FrancescoRocca/hackTurin-2026/openscad/smart-camera/previews/body_back.png

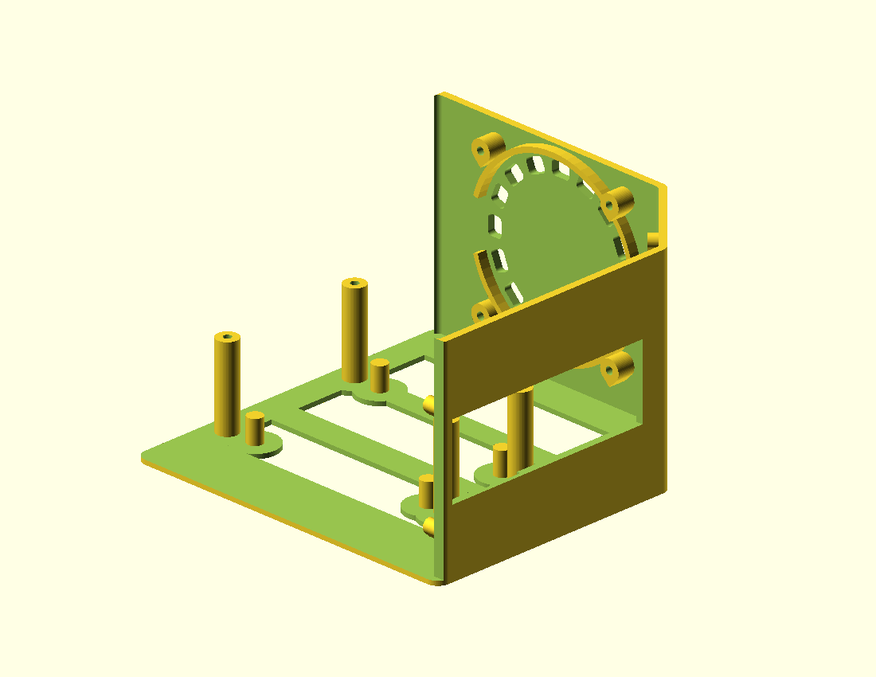
openscad/smart-camera/previews/body_back.png
