FrancescoRocca/hackTurin-2026/openscad/smart-camera/previews/body_front.png

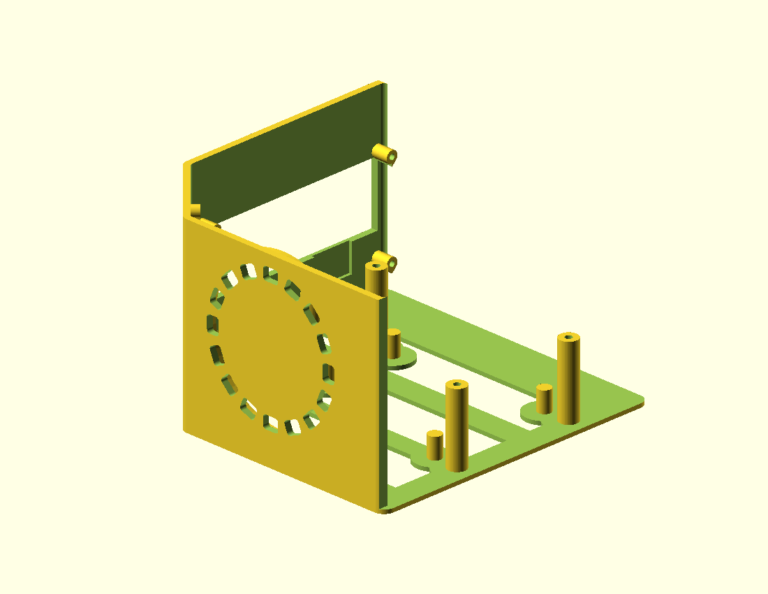
openscad/smart-camera/previews/body_front.png
