FrancescoRocca/hackTurin-2026/openscad/smart-camera/previews/body_top_inside.png

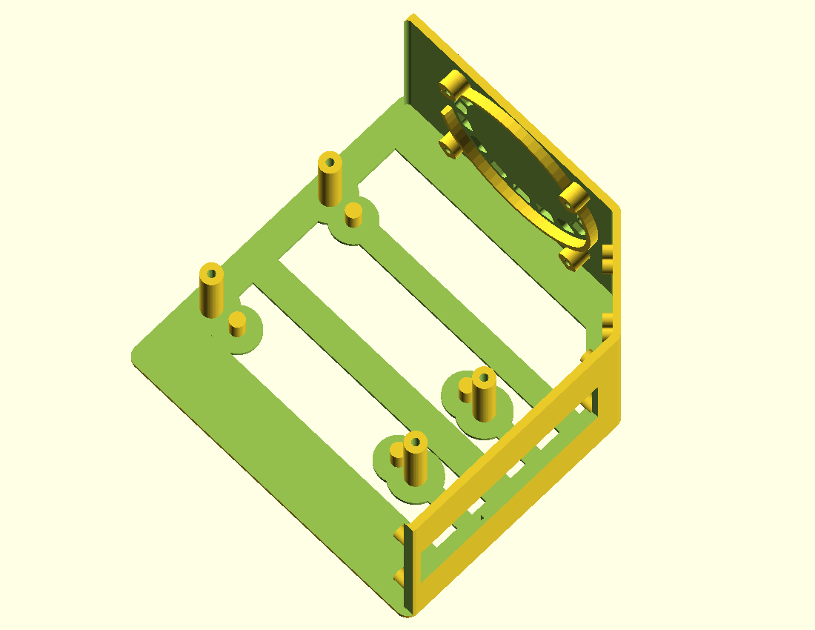
openscad/smart-camera/previews/body_top_inside.png
