FrancescoRocca/hackTurin-2026/openscad/smart-camera/previews/buzzer.png

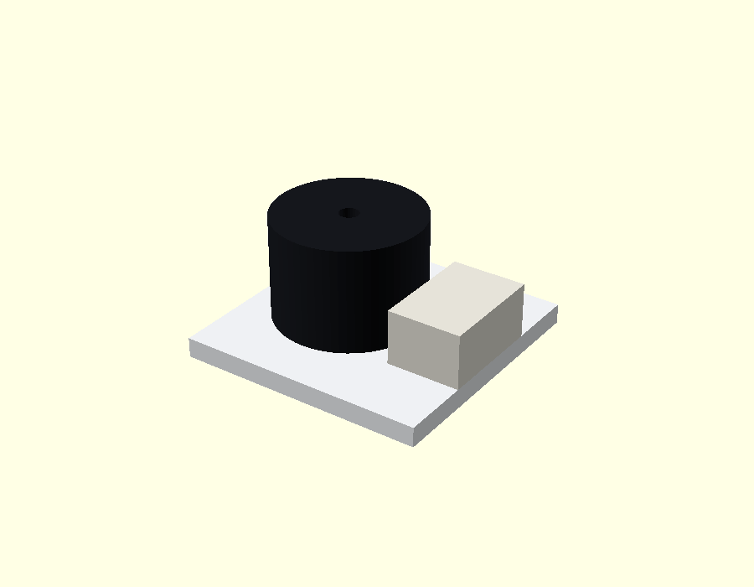
openscad/smart-camera/previews/buzzer.png
