FrancescoRocca/hackTurin-2026/openscad/smart-camera/previews/buzzer_fit_close.png

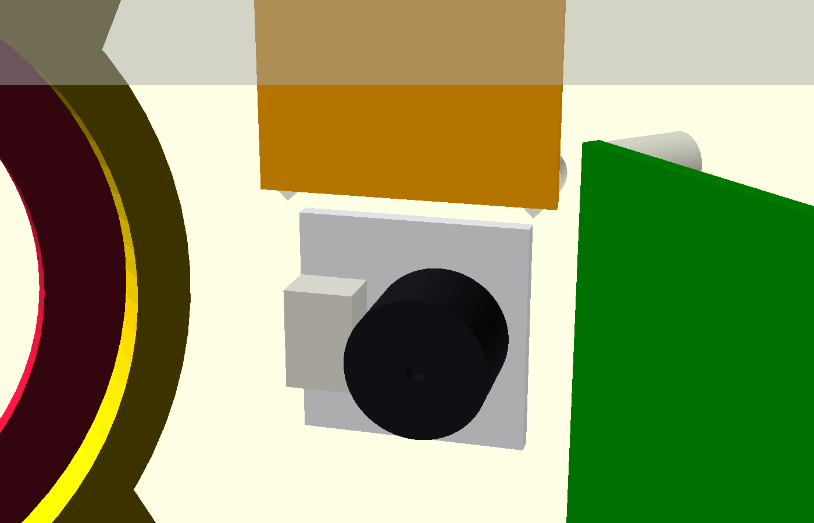
openscad/smart-camera/previews/buzzer_fit_close.png
