FrancescoRocca/hackTurin-2026/openscad/smart-camera/previews/camera_front.png

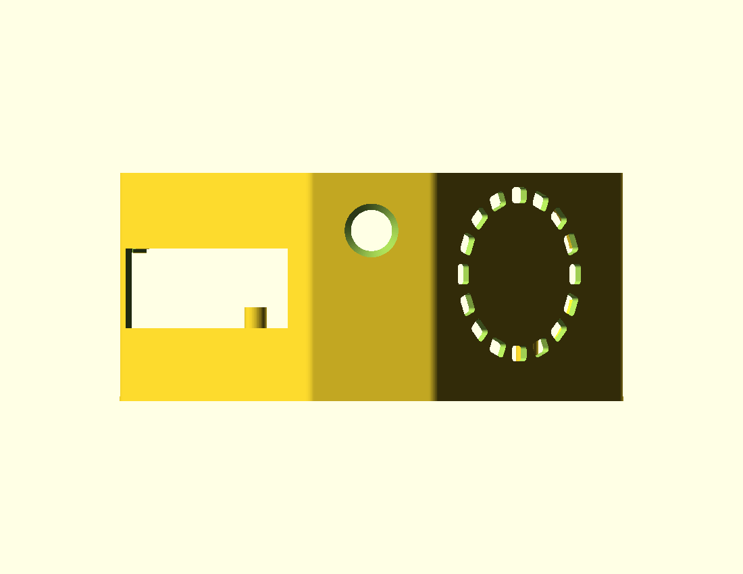
openscad/smart-camera/previews/camera_front.png
