FrancescoRocca/hackTurin-2026/openscad/smart-camera/previews/clamp_inner.png

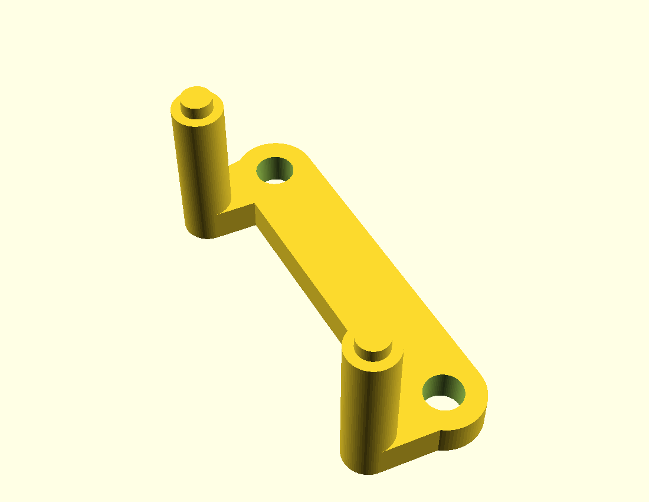
openscad/smart-camera/previews/clamp_inner.png
