FrancescoRocca/hackTurin-2026/openscad/smart-camera/previews/clamp_usb.png

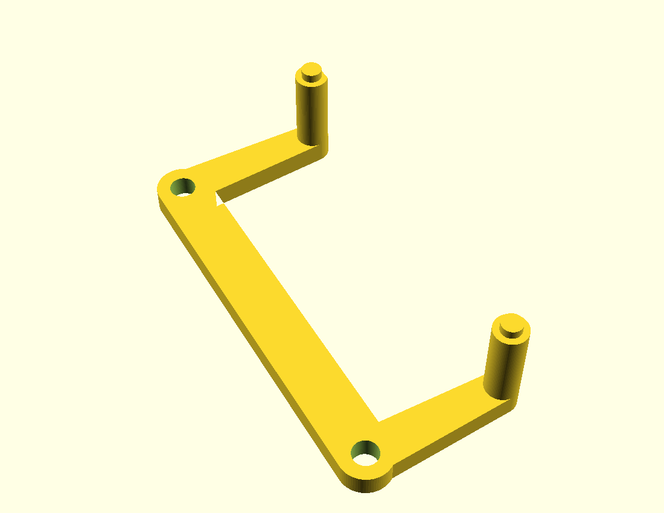
openscad/smart-camera/previews/clamp_usb.png
