FrancescoRocca/hackTurin-2026/openscad/smart-camera/previews/fit_back_buzzer.png

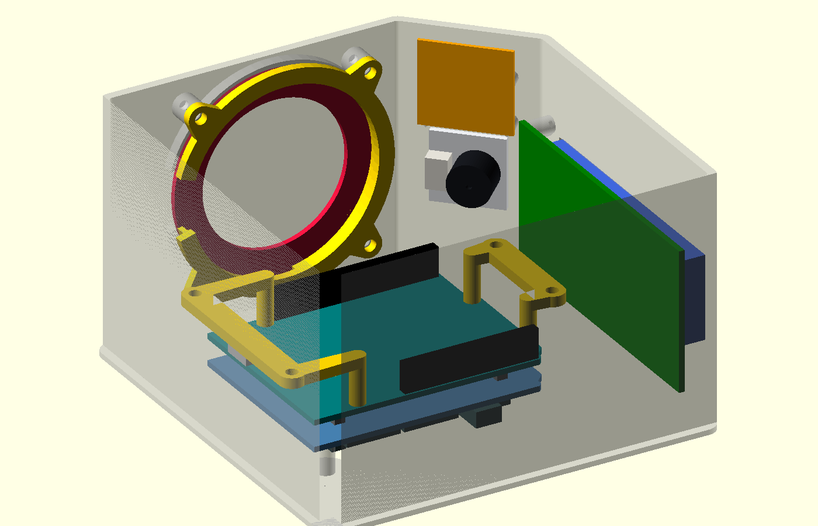
openscad/smart-camera/previews/fit_back_buzzer.png
