FrancescoRocca/hackTurin-2026/openscad/smart-camera/previews/fit_front.png

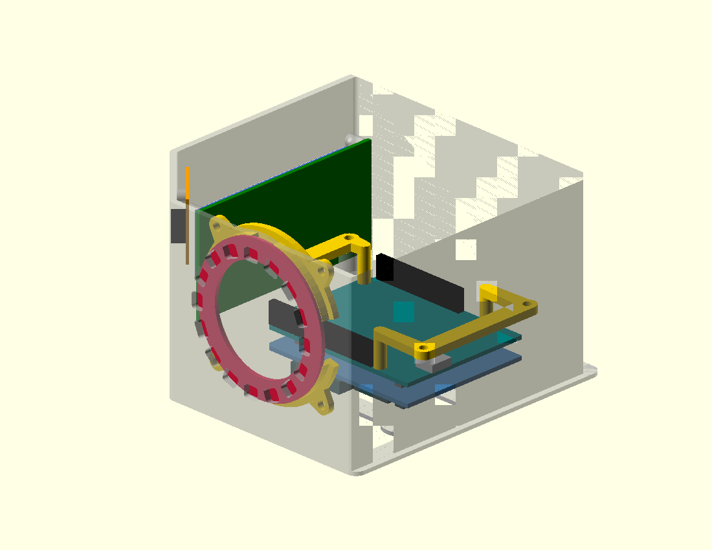
openscad/smart-camera/previews/fit_front.png
