FrancescoRocca/hackTurin-2026/openscad/smart-camera/previews/fit_left_inside.png

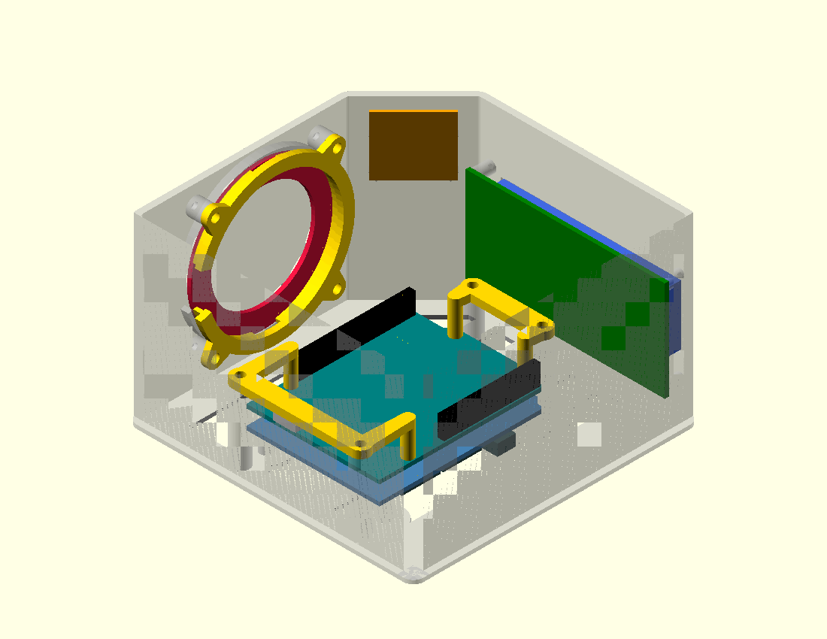
openscad/smart-camera/previews/fit_left_inside.png
