FrancescoRocca/hackTurin-2026/openscad/smart-camera/previews/lid.png

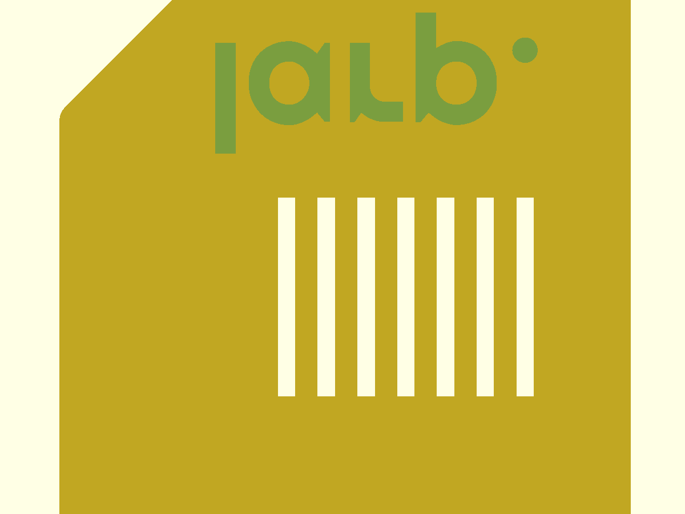
openscad/smart-camera/previews/lid.png
