FrancescoRocca/hackTurin-2026/openscad/smart-camera/previews/ring_retainer.png

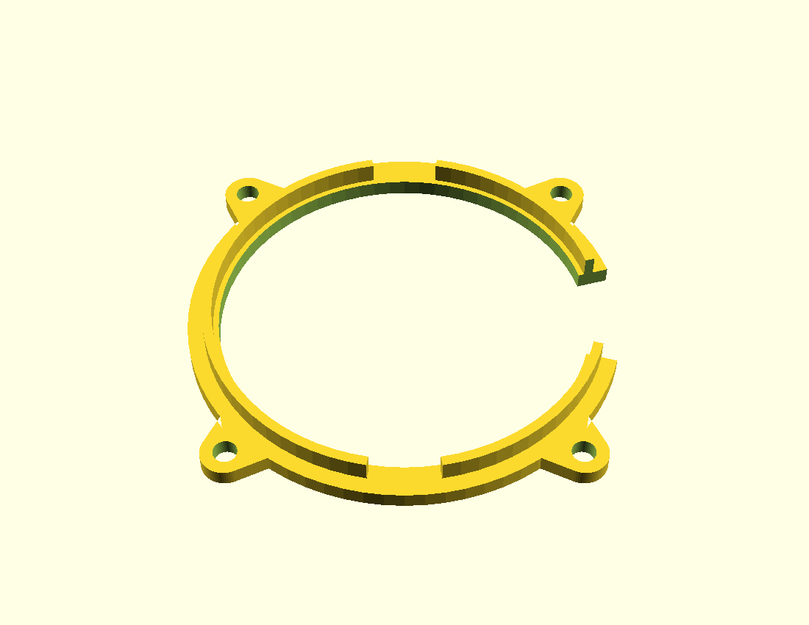
openscad/smart-camera/previews/ring_retainer.png
