FrancescoRocca/hackTurin-2026/openscad/smart-camera/renders/body_before.png

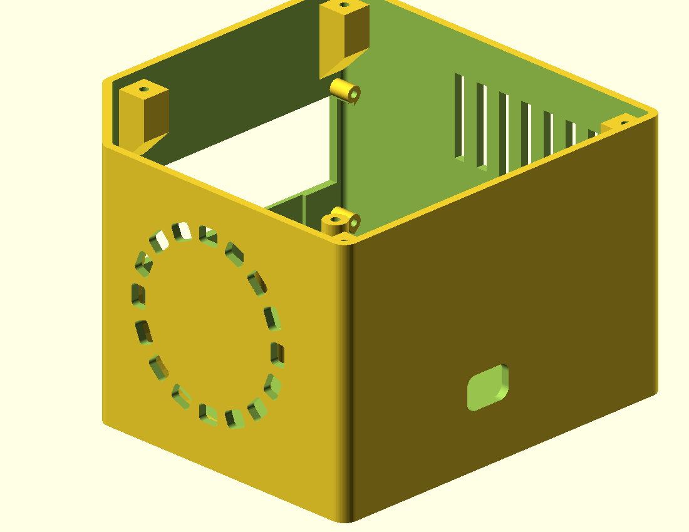
openscad/smart-camera/renders/body_before.png
