FrancescoRocca/hackTurin-2026/openscad/smart-camera/video/stl/body_asm.stl

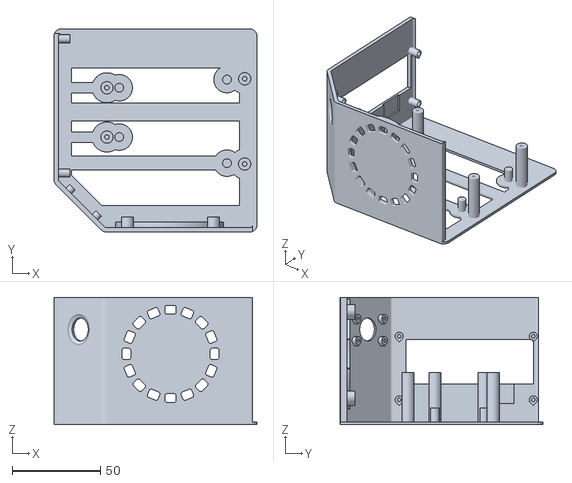
[picture p19: CAD file, 2026-10-11]
openscad/smart-camera/video/stl/body_asm.stl
115.0 x 115.0 x 72.0
