FrancescoRocca/hackTurin-2026/openscad/smart-camera/video/stl/clamp_usb_asm.stl

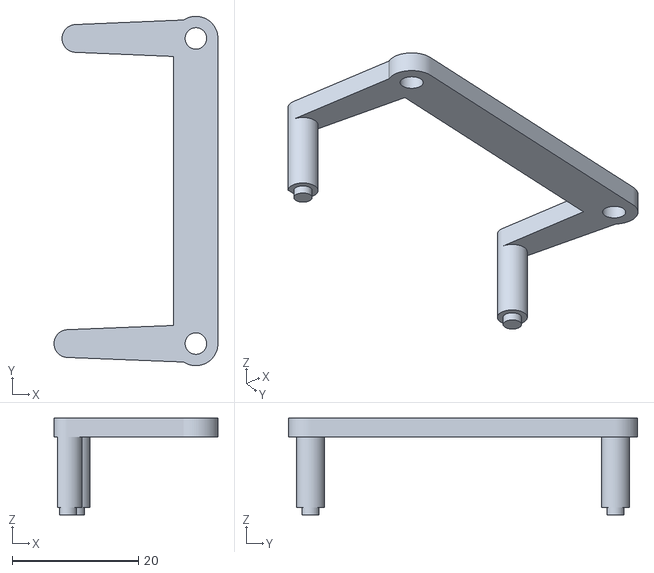
[picture p20: CAD file, 2026-10-11]
openscad/smart-camera/video/stl/clamp_usb_asm.stl
25.9 x 55.3 x 15.3
