FrancescoRocca/hackTurin-2026/openscad/smart-camera/video/stl/lid_asm.stl

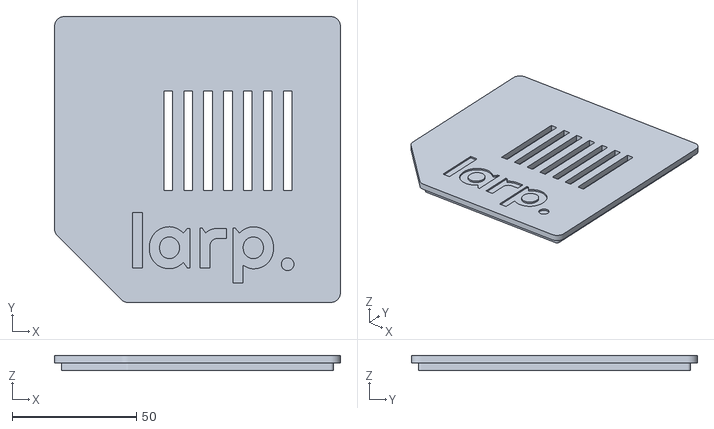
[picture p21: CAD file, 2026-10-11]
openscad/smart-camera/video/stl/lid_asm.stl
115.0 x 115.0 x 6.00
