FrancescoRocca/hackTurin-2026/openscad/smart-camera/video/stl/clamp_inner_asm.stl

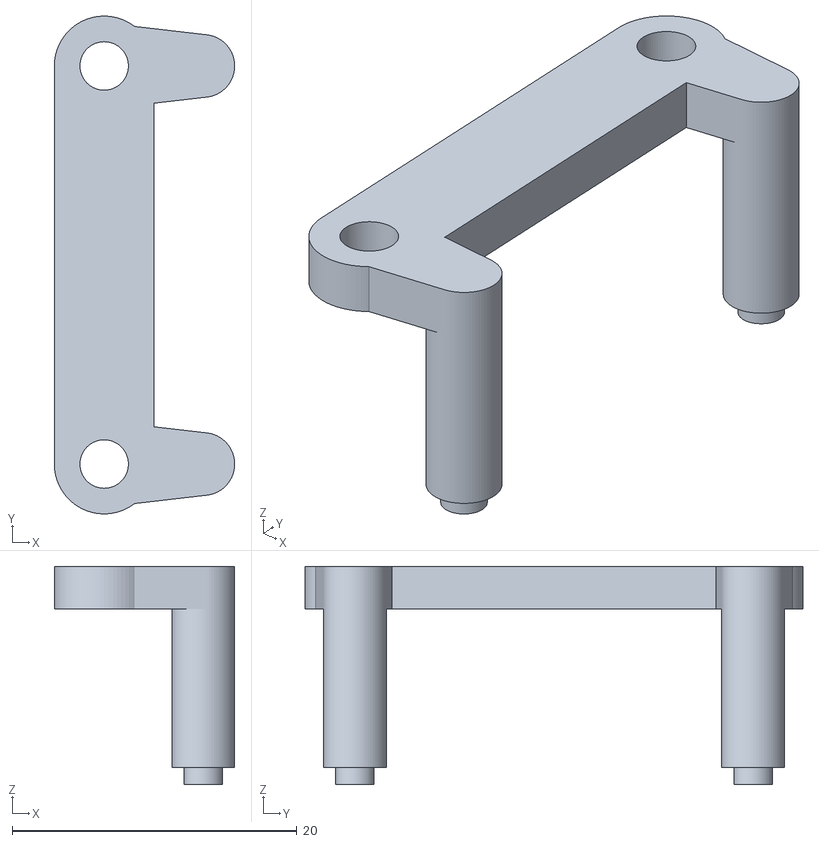
[picture p22: CAD file, 2026-10-11]
openscad/smart-camera/video/stl/clamp_inner_asm.stl
12.7 x 34.9 x 15.3
