FrancescoRocca/hackTurin-2026/openscad/smart-camera/video/stl/retainer_asm.stl

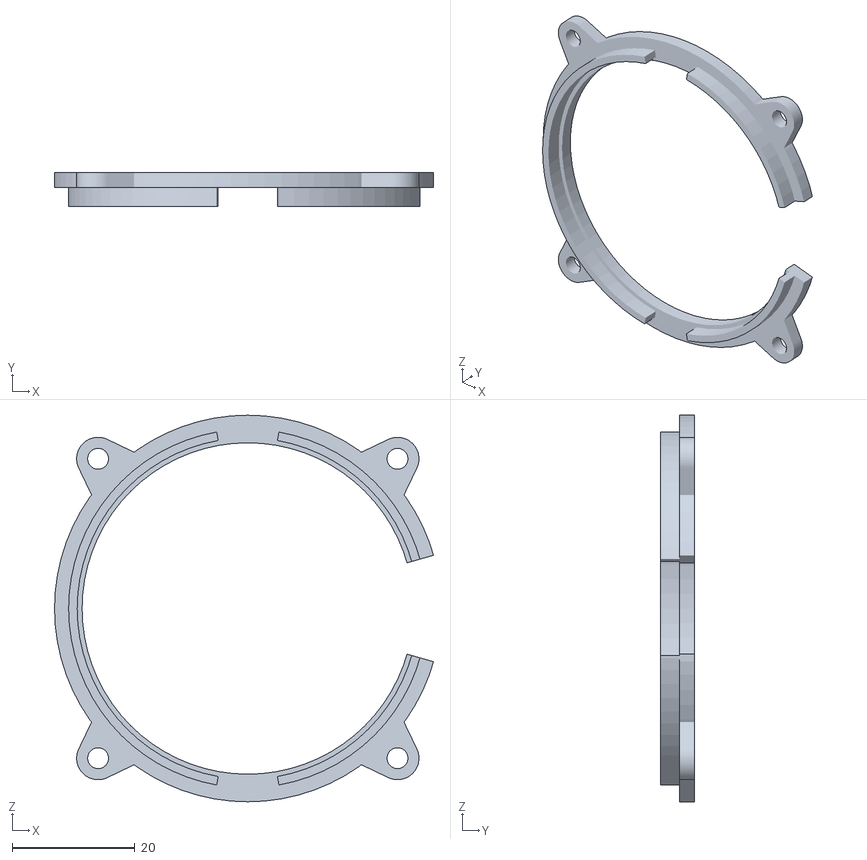
[picture p23: CAD file, 2026-10-11]
openscad/smart-camera/video/stl/retainer_asm.stl
61.8 x 5.60 x 63.0
