FrancescoRocca/hackTurin-2026/openscad/smart-camera/stl/grove_passive_buzzer_mock.stl

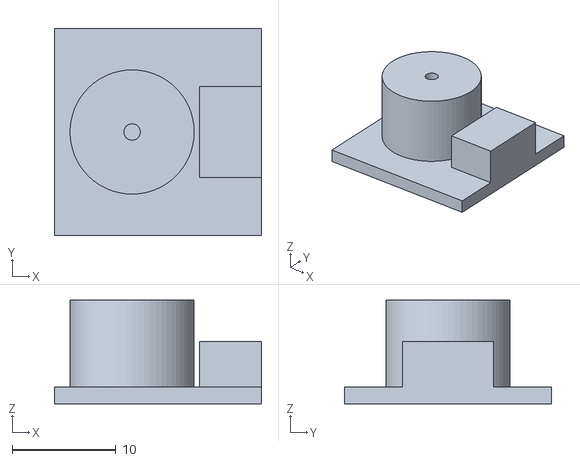
[picture p24: CAD file, 2026-10-11]
openscad/smart-camera/stl/grove_passive_buzzer_mock.stl
20.0 x 20.0 x 10.0
