FrancescoRocca/hackTurin-2026/openscad/smart-camera/stl/smart_camera_logo_inlay.stl

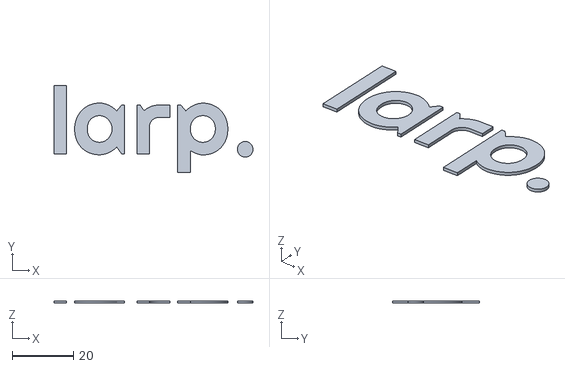
[picture p25: CAD file, 2026-10-11]
openscad/smart-camera/stl/smart_camera_logo_inlay.stl
64.9 x 28.4 x 0.8
