FrancescoRocca/hackTurin-2026/openscad/smart-camera/logo/larp_logo.scad

// 2D "larp" wordmark, identical to the text engraved on the lid
// (same font, size, spacing as smart_camera_enclosure.scad).
// Export:  openscad -o logo/larp.svg logo/larp_logo.scad     (from smart-camera/)
include <../smart_camera_enclosure.scad>
part = "none";
logo_text2d();
