FrancescoRocca/hackTurin-2026/(list of files, cad)

Other CAD files:
openscad/smart-camera/stl/smart_camera_ring_retainer.stl
openscad/smart-camera/stl/smart_camera_clamp_usb.stl
openscad/smart-camera/stl/smart_camera_lid.stl
openscad/smart-camera/stl/smart_camera_clamp_inner.stl
