FrancescoRocca/hackTurin-2026/(commit log)

2026-10-11 feat: add openscad folder
    [body_asm.stl, clamp_inner_asm.stl, clamp_usb_asm.stl, grove_passive_buzzer.scad, grove_passive_buzzer_mock.stl, larp_logo.scad, lid_asm.stl, retainer_asm.stl]
2026-10-11 feat: add arduino & dashboard
2026-10-11 docs: add project README with enclosure render and prototype photos
